UT8IFG/karpaty-rx/README.md

# Реплика радиоприемника «Карпаты»

Проект по оцифровке материалов и доработке радилюбительского КВ-приемника «Карпаты», опубликованного в журнале «Радио» (№11-12 за 1987 год).

## 📌 О проекте
Цель проекта — оцифровать печатные платы для сборки радиоприемника, упростить возможность модификации печатных плат под имеющиеся радиокомпоненты.
* **Авторы приемника:** Ю. Бахмутский (UB4LGP), В. Калаев (RB5LEN)
* **Первоисточник:** Журнал «Радио», [№11 1987 г. (стр. 31–33)](http://archive.radio.ru/web/1987/11/), [№12 1987 г. (стр. 19–21, вкл. 2-3)](http://archive.radio.ru/web/1987/12/).
* **Технологии:** Sprint-Layout 6.0.

## 📂 Структура репозитория
* `/docs/original-articles/` — оригинальные сканы страниц журнала в формате JPG.
* `/docs/datasheet/` — справочные материалы.
* `/sch/` — принципиальные электрические схемы.
* `/pcb/` — файлы печатных плат.
* `/pcb/mod/` — модифицированные файлы печатных плат.
* `/pcb/*/img/` — изображения печатных плат.
* `/pcb/macros/` — созданные в процессе работы макросы для Sprint-Layout.

## 🛠 Технические подробности
Печатные платы оптимизированы под домашнее производство с помощью ЛУТ: крупные контактные площадки, толстые дорожки, минимальный диаметр отверстий - 0,8 мм. 

**Внимание!**  Шелкография для диодов КД522Б соотвествует их внешнему виду, то есть широкая полоса обозначает **анод**. При установке диодов 1N4148 необходимо учитывать, что полоска на корпусе диода указывет на **катод**.

## ✅ Статус оцифровки печатных плат

Нажмите на изображение платы, чтобы перейти к файлу в формате `.lay6`.

### Плата №1 (ДПФ)
На плате расположены диапазонные фильтры сосредоточенной селекции.

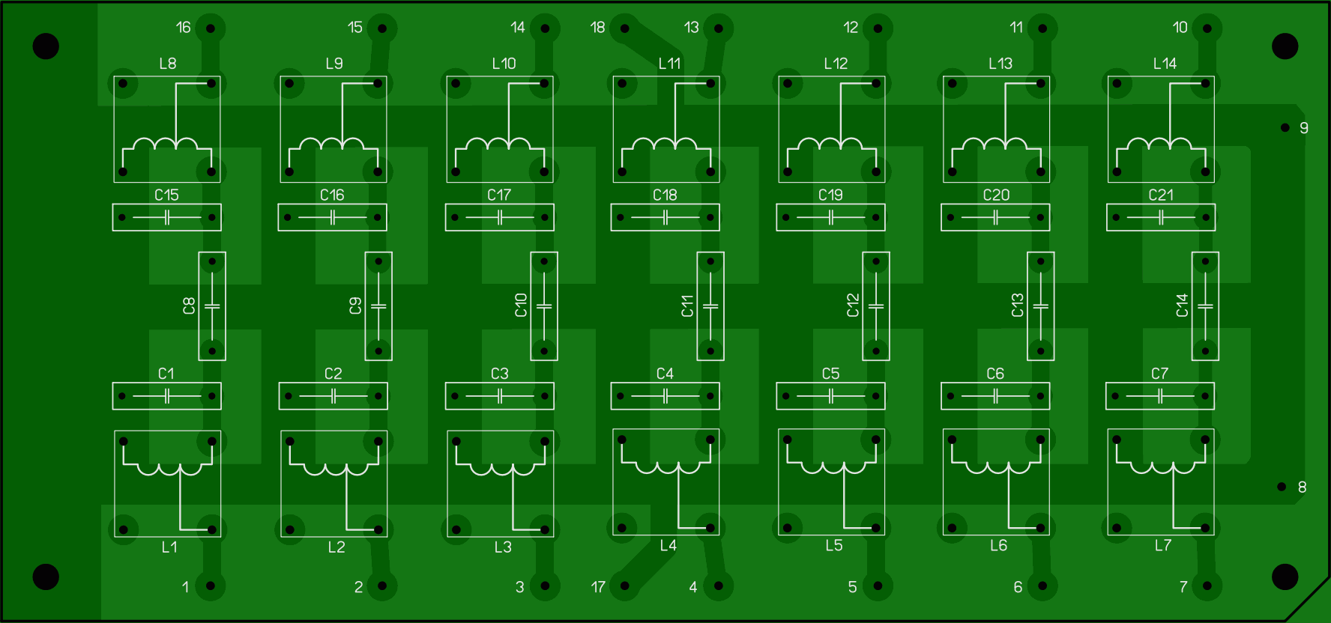
[picture p1: pcb/original/img/karpaty-rx-pcb1-bpf-orig-preview.png]
Плата №1 Фотовид


### Плата №2 (УРЧ + первый смеситель)
На плате расположен усилитель радиочастоты, согласующий каскад и первый смеситель.

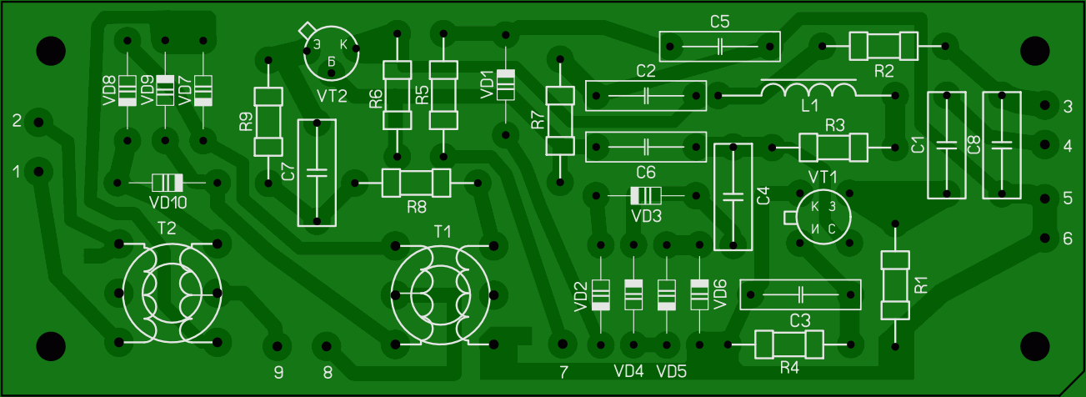
[picture p2: pcb/original/img/karpaty-rx-pcb2-rfamp-1st-mixer-orig-preview.png]
Фотовид платы УРЧ и первого смесителя приемника Карпаты


### Плата №3 (ГПД)
Плата генератора плавного диапазона (ГПД).

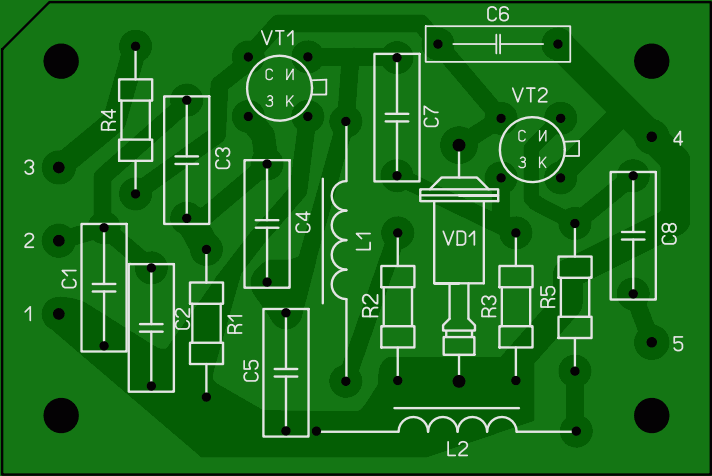
[picture p3: pcb/original/img/karpaty-rx-pcb3-vfo-orig-preview.png]
Фотовид платы ГПД приемника Карпаты


### Плата №4
Не является печатной платой. 

Содержит подстроечные и постоянные конденсаторы, задающие границы работы ГПД на диапазонах. 

Элементы монтируются на металлической пластине навесным монтажом.

### Плата №5 (Повторители + удвоитель частоты)
Плата содержит повторители и удвоитель частоты ГПД.

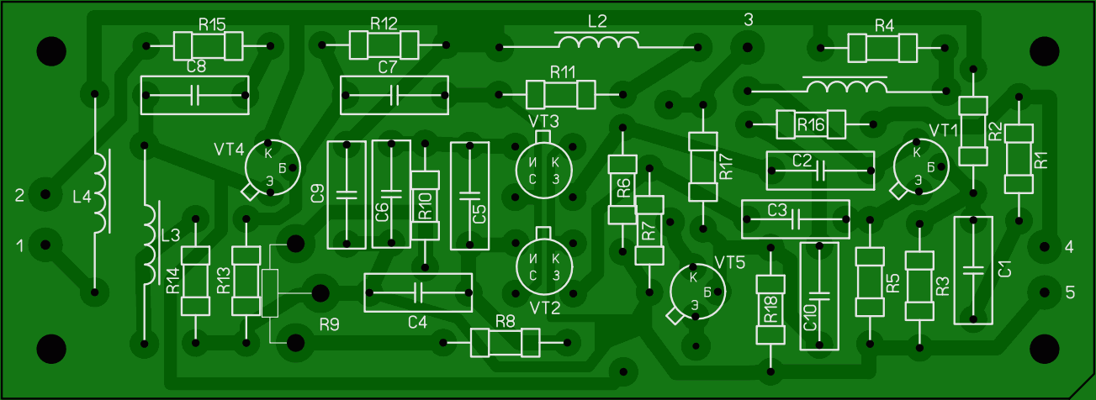
[picture p4: pcb/original/img/karpaty-rx-pcb5-buffer-freq-doubler-orig-preview.png]
Фотовид платы повторителей и удвоения частоты приемника Карпаты


### Плата №6 (Основная плата)
Центральный блок приемника, содержащий второй смеситель, тракт ПЧ, опорные генераторы, АРУ, детектор и УНЧ.

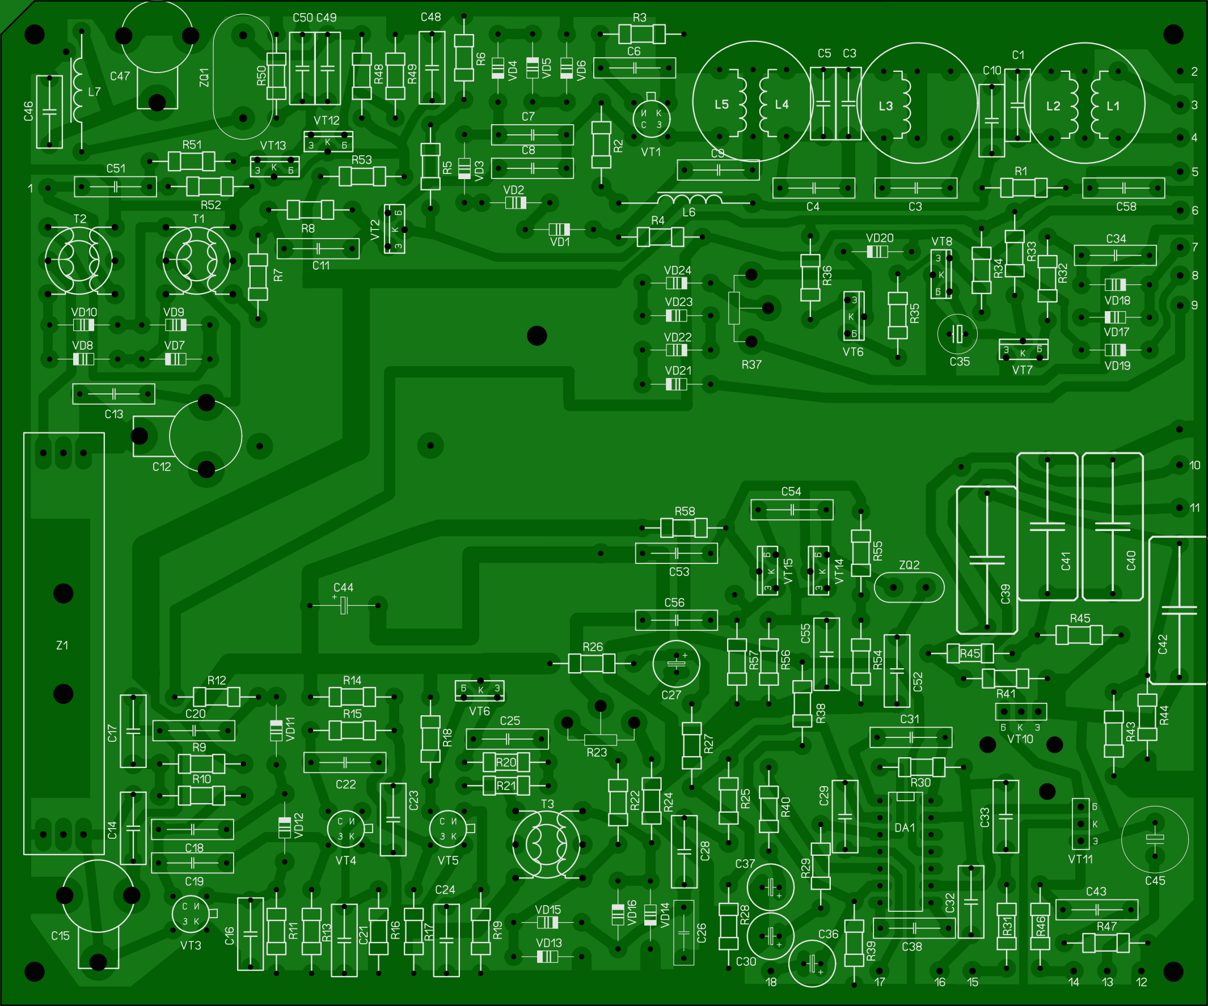
[picture p5: pcb/original/img/karpaty-rx-pcb6-mainboard-orig-preview.png]
Плата №6 Фотовид


### Плата №7 (Блок питания)
Плата источника питания. Содержит выпрямитель, фильтрующие ёмкости и стабилизатор напряжения.

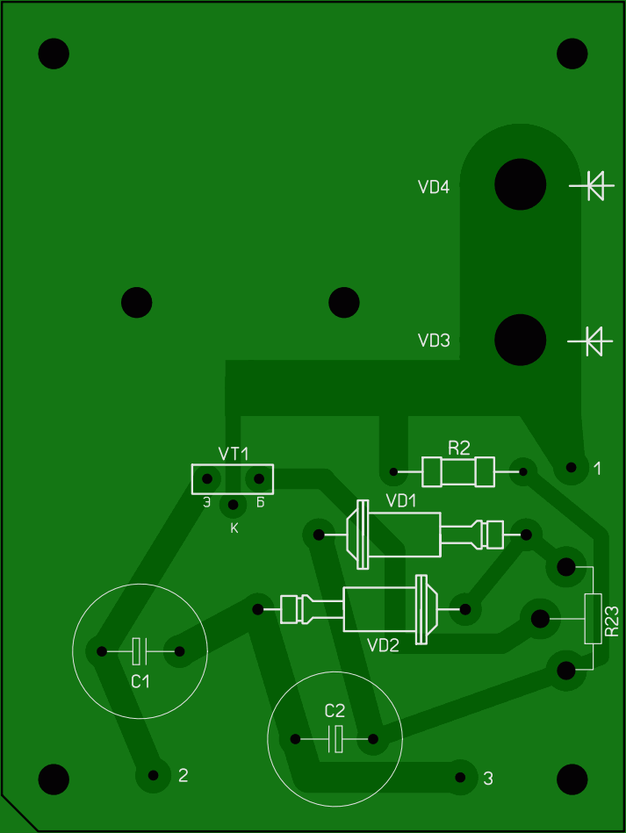
[picture p6: pcb/original/img/karpaty-rx-pcb7-power-supply-orig-preview.png]
Фотовид платы блока питания приемника Карпаты


## 🔧 Модифицированные печатные платы
Модификации оригинальных печатных плат под имеющиеся радиокомпоненты или из других соображений. 

### Плата №1 (ДПФ)

#### Модификация платы под имеющиеся каркасы контурных катушек

Фото каркасов:
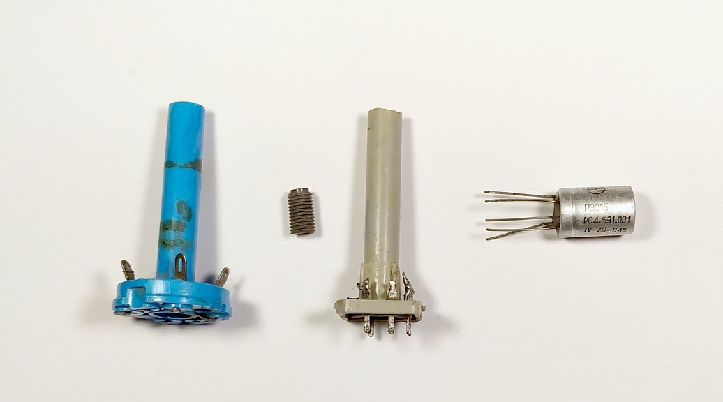
[picture p7: pcb/mod/img/karpaty-rx-pcb1-bpf-mod-components.jpg]
Фото радиокомпонентов модифицированной платы ДПФ приемника Карпаты


Плата:
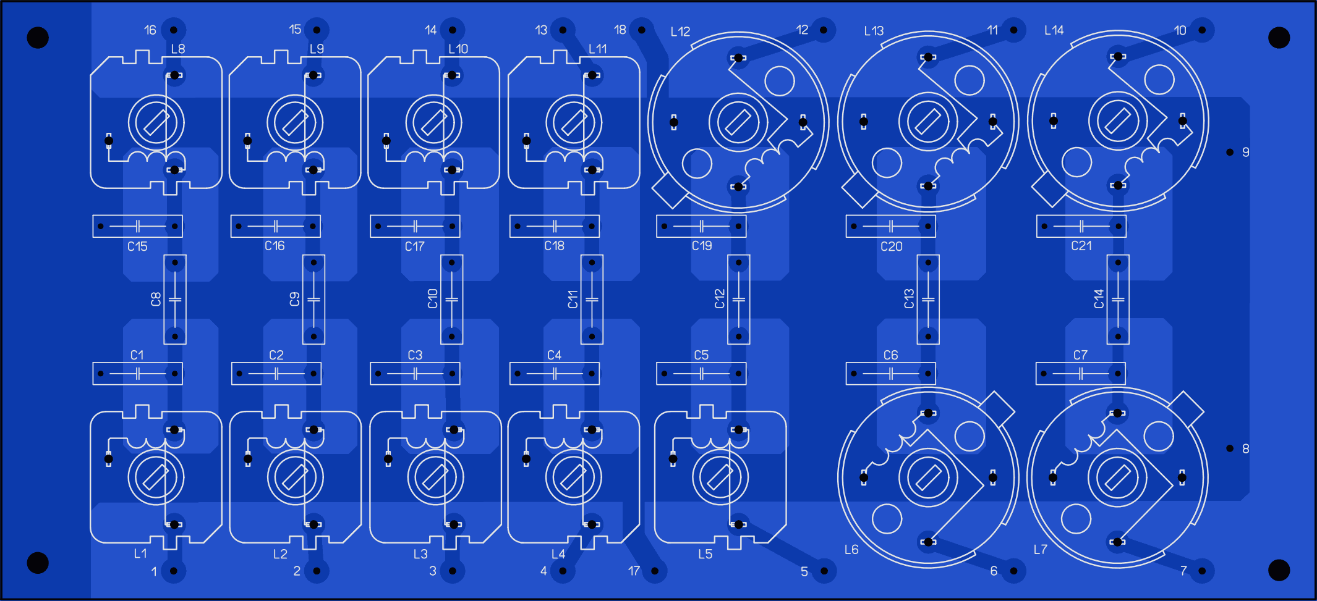
[picture p8: pcb/mod/img/karpaty-rx-pcb1-bpf-mod-preview.png]


---
#### Модификация платы под микроконтроллерное управление с релейной коммутацией

В качестве переключающего элемента использованы реле РЭС15 на напряжение 27В (паспорт PC4.591.0011П2). 

Управление реализовано на транзисторах КТ940 (с любой буквой). Каждый транзистор переключает два реле. 

***При использовании реле РЭС15 с другим паспортом может потребоваться замена транзистора на более подходящий по току.***

Схема коммутации:

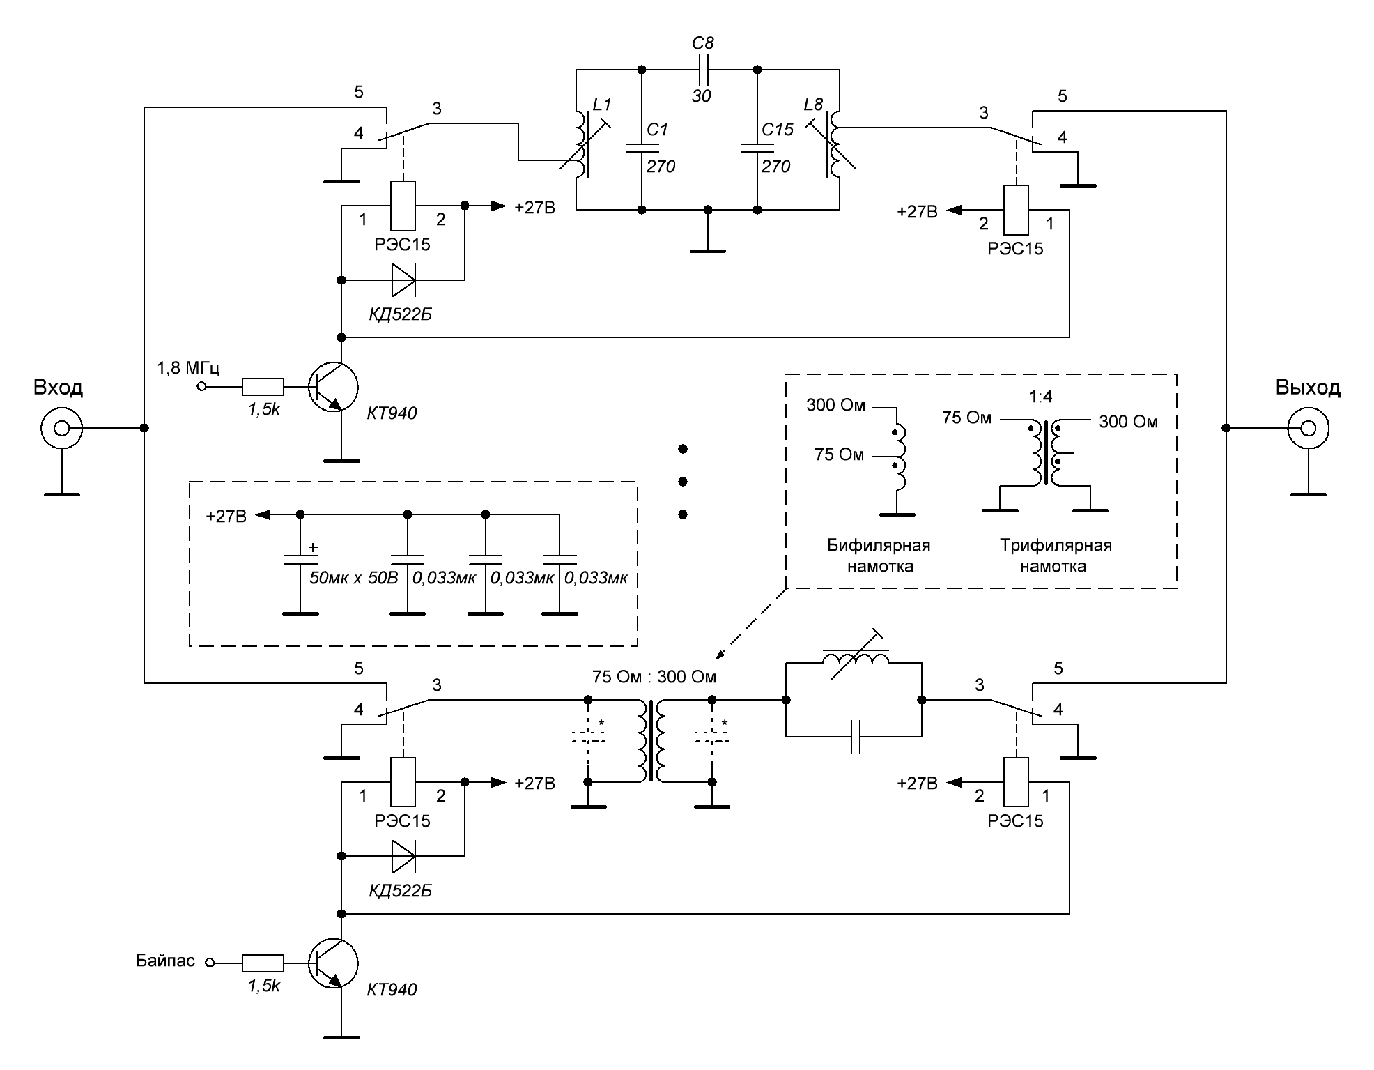
[picture p9: sch/bpf-relay-switch.png]
Схема релейной коммутации ДПФ приемника Карпаты


В схему коммутации добавлен режим обхода ("байпас") для возможности прослушивания сигналов за пределом фиксированных радиолюбительских диапазонов.

Так как приемник супергетеродинный, то такой режим сильно ухудшает избирательные свойства по зеркальному каналу. 

В режиме обхода добавлен согласующий широкополосный трансформатор сопротивлений 1:4 и режекторный фильтр на частоту первой ПЧ - 5 МГц. Эти меры должны улучшить согласование антенны с фильтром и избавить от возможных мешающих сигналов на первой ПЧ, которые могут прослушиваться при настройке приемника на любую частоту.

Трансформатор выполнен на ферритовом кольце, а катушка режекторного фильтра - на том же каркасе, что и катушки полосовых фильтров.

Конденсаторы на входе и выходе трансформатора устанавливаются при завале АЧХ, а их емкость подбирается в диапазоне 5-47 пФ.

***Данные о трансформаторе и режекторном фильтре будут уточняться в процессе сборки и наладки приемника.***

Размер платы - 205 мм Х 140 мм.

Плата:

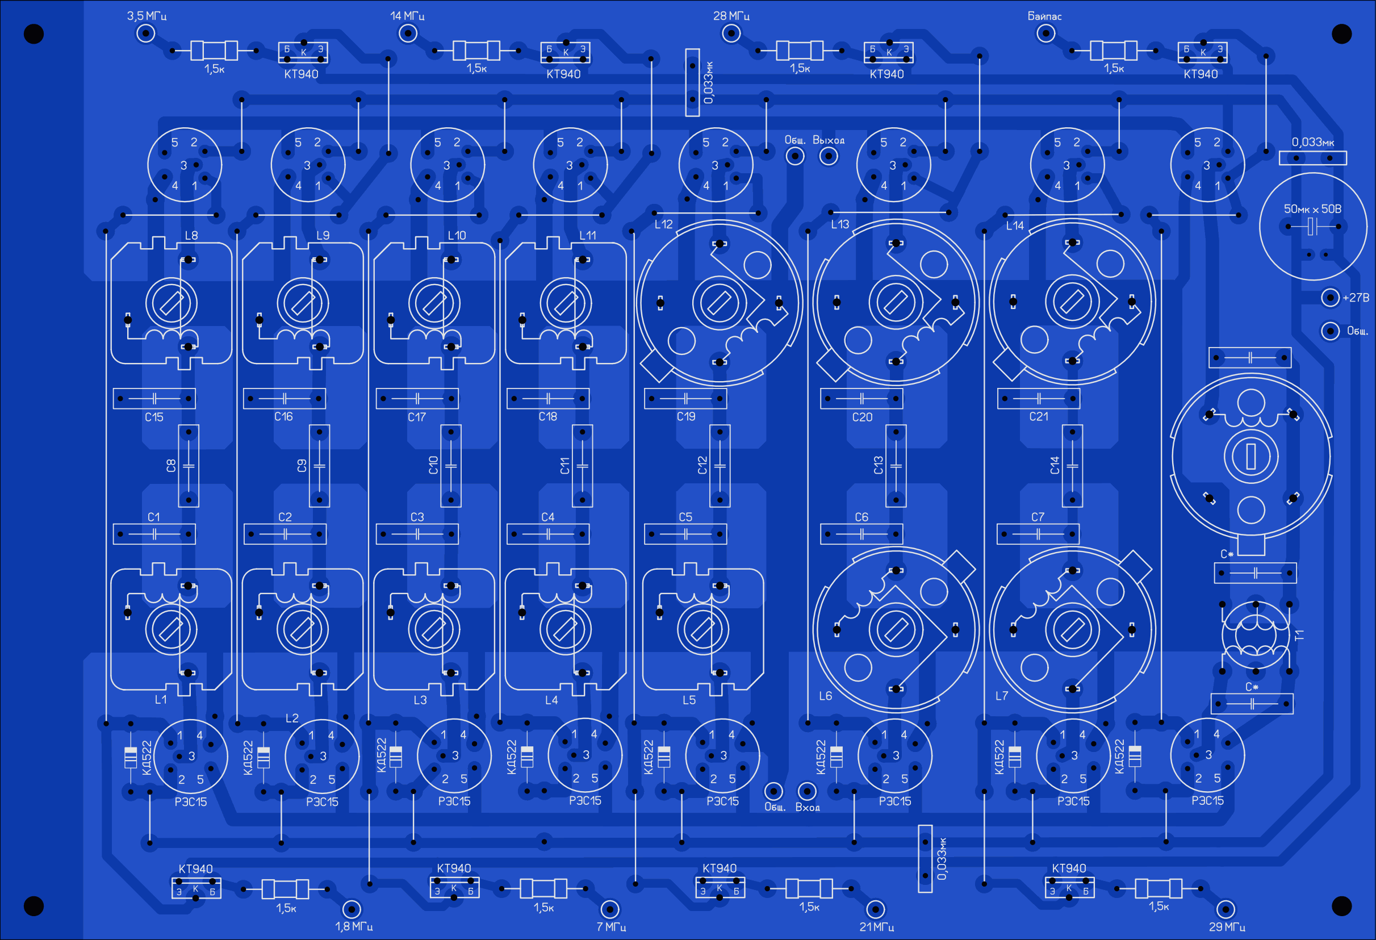
[picture p10: pcb/mod/img/karpaty-rx-pcb1-bpf-relay-mod-preview.png]
Фотовид модифицированной платы ДПФ приемника Карпаты с релейной коммутацией


Вход и выход ВЧ-сигнала подключаются к контактным площадкам "Вход", "Общ." и "Выход", "Общ." соответственно.

Для заземления корпусов реле предусмотрены контактные площадки в непосредственной близости с корпусом.

Питание для реле подается на контакты "+27В" и "Общ.". Общий провод питания изолирован от сигнальной "земли" платы, чтобы не создавать земляных петель и разделить сигнальную и управляющую части. 

Фильтрация питания реле состоит из электролитического конденсатора 20-50 мкФ х 50 В (К50-6) и трех керамических конденсаторов на 33-100 нФ (например К10-7). Предусмотрено посадочное место под установку современного электролитического конденсатора значительно меньшего размера.

### Плата №6 (Основная плата)
Модификация платы под имеющиеся радиокомпоненты. 

Список основных изменений:
* заменены посадочные места и шелкогарфия контуров полосового фильтра L1-L5;
* C35, C37: добавлены посадочные места под ниобиевые конденсаторы К53-4;
* C1, C3, C5: добавлены посадочные места под КСО-1;
* С2, С4: добавлены посадочные места под КД-1-3;
* C13, C14: добавлены посадочные места под КТ-2;
* C31, C38 уменьшен размер под дисковый керамический;
* VT10, VT11: добавлены радиаторы и крепеж;
* Удалены отверстия крепления радиатора;
* С45 заменен на К50-6 200 мкФ х 25В, старое посадочное место сохранено.

Фото компонентов:
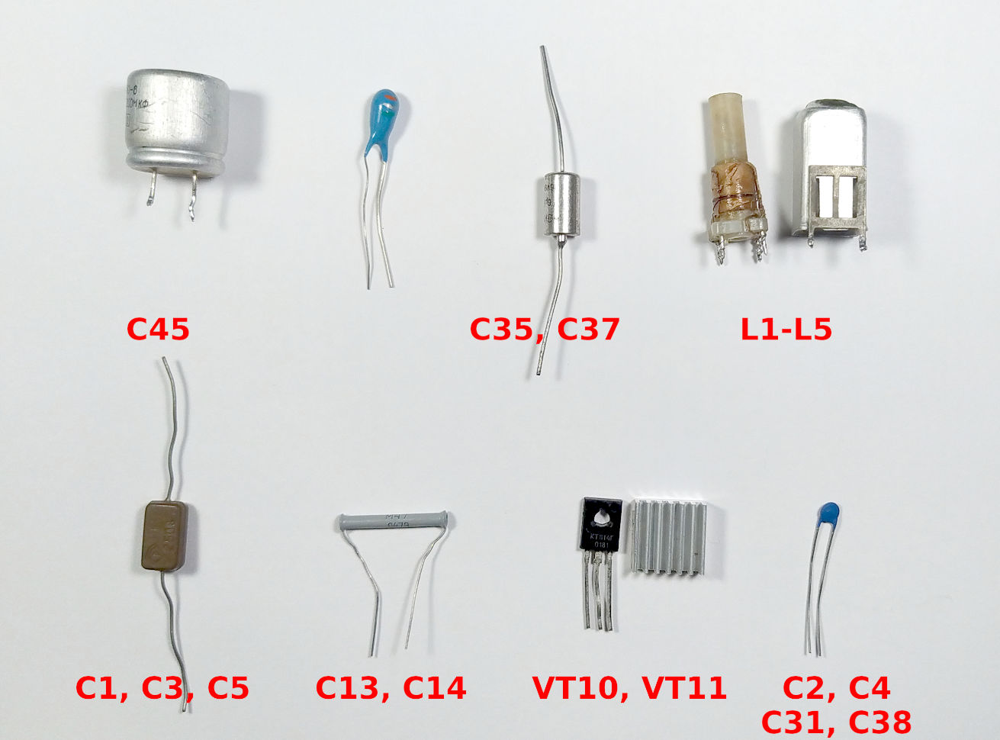
[picture p11: pcb/mod/img/karpaty-rx-pcb6-mainboard-mod-components.jpg]
Фото радиокомпонентов модифицированной основной платы приемника Карпаты


Плата:
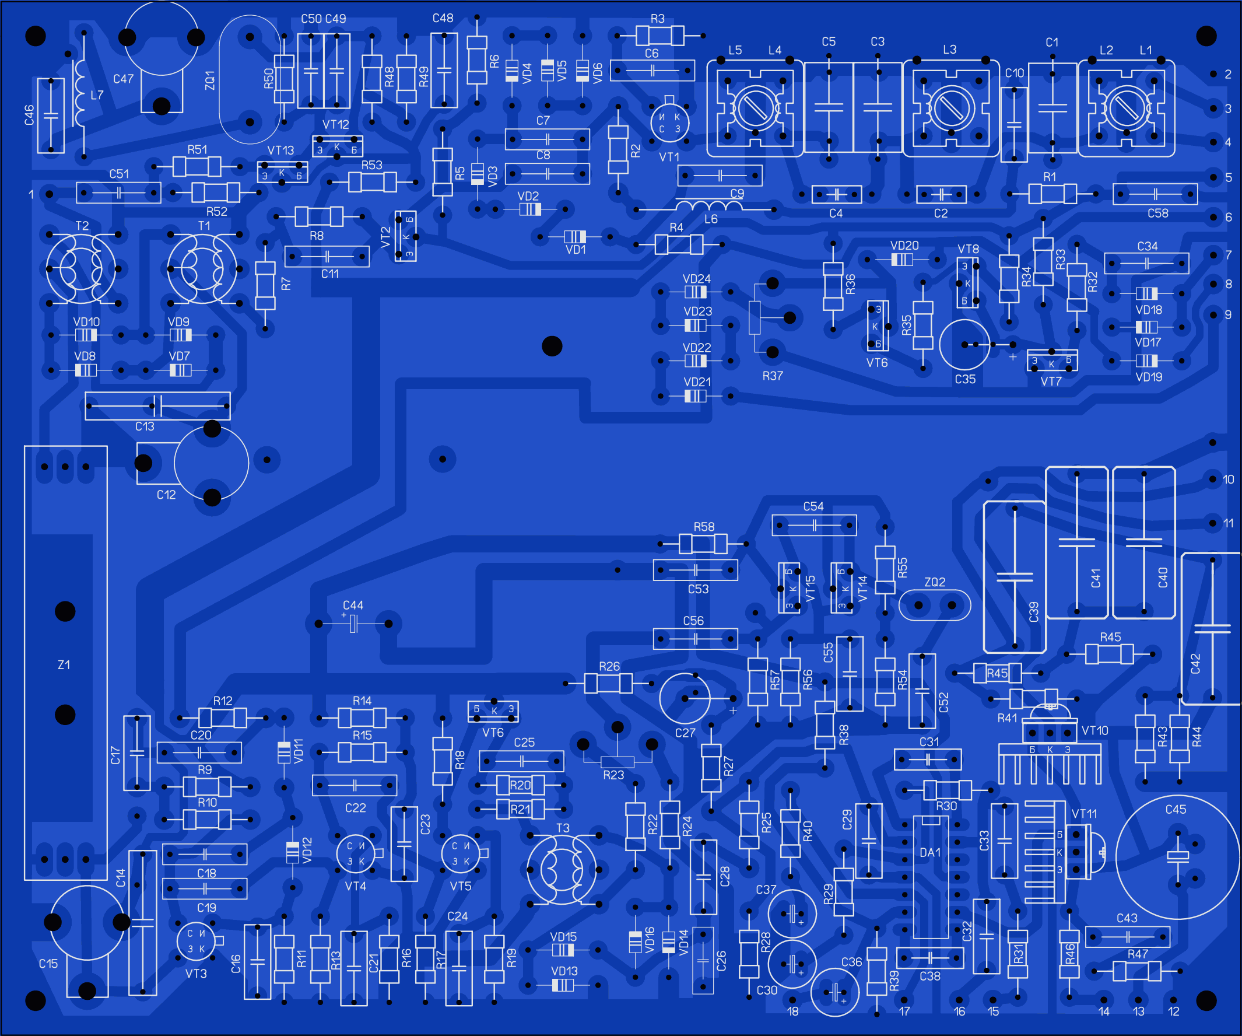
[picture p12: pcb/mod/img/karpaty-rx-pcb6-mainboard-mod-preview.png]


<a href="pcb/mod/img/karpaty-rx-pcb6-mainboard-mod-compare-preview.gif">Анимированное изображение</a> внесённых изменений относительно оригинальной платы.

---
*Проект находится в стадии наполнения.*
