UT8IFG/karpaty-rx/docs/original-articles/b.1987-11.035.jpg

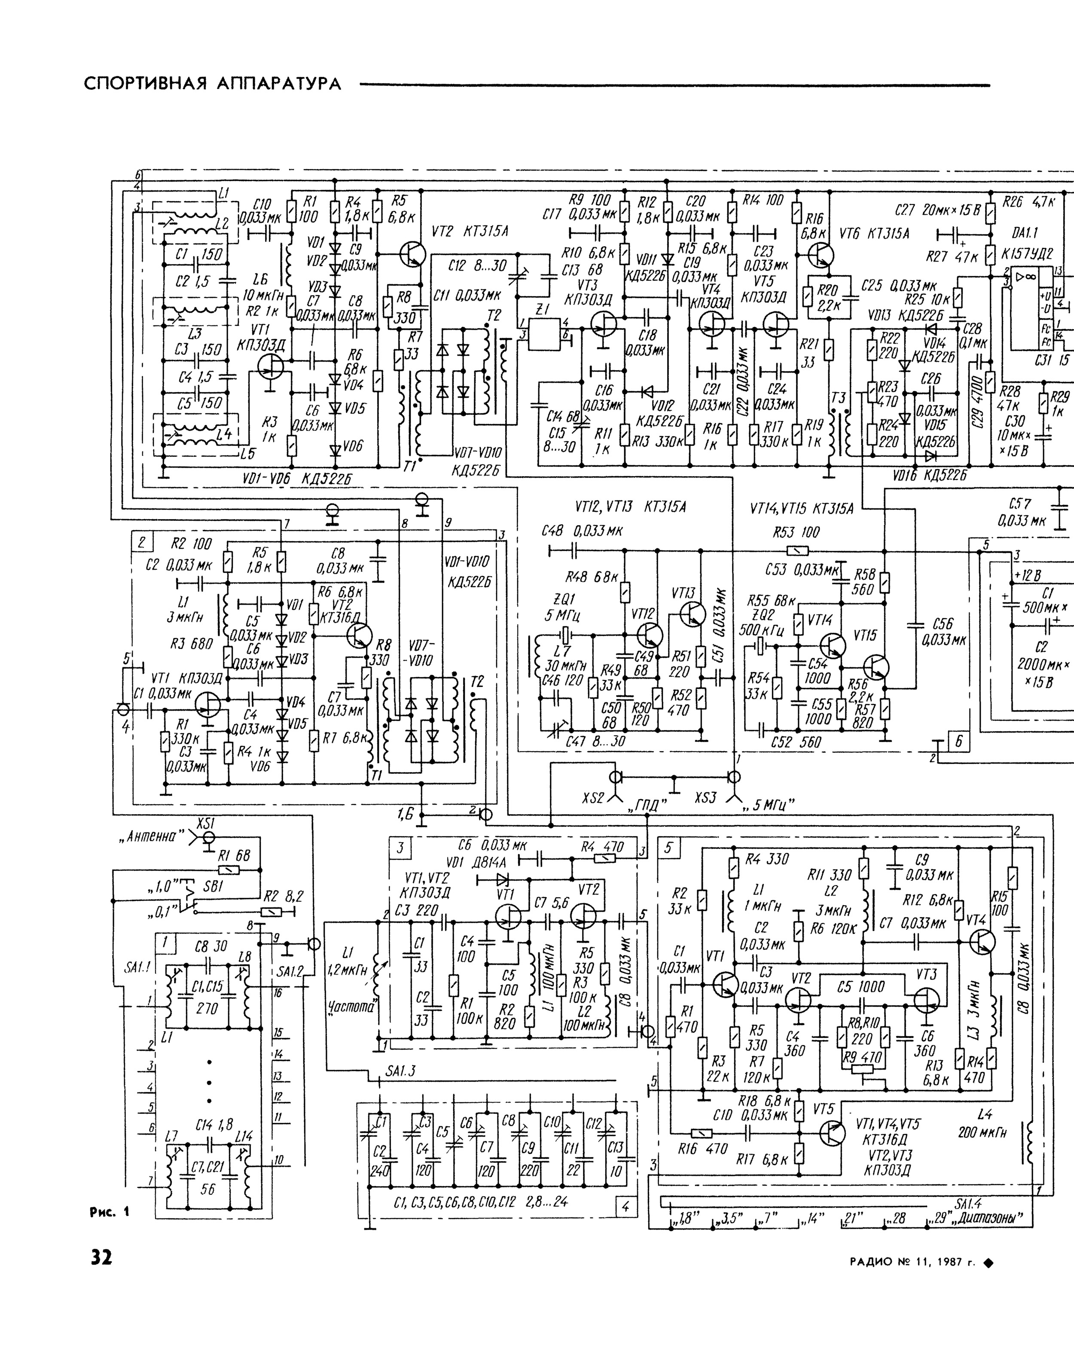
docs/original-articles/b.1987-11.035.jpg
