UT8IFG/karpaty-rx/docs/original-articles/b.1987-12.020.jpg

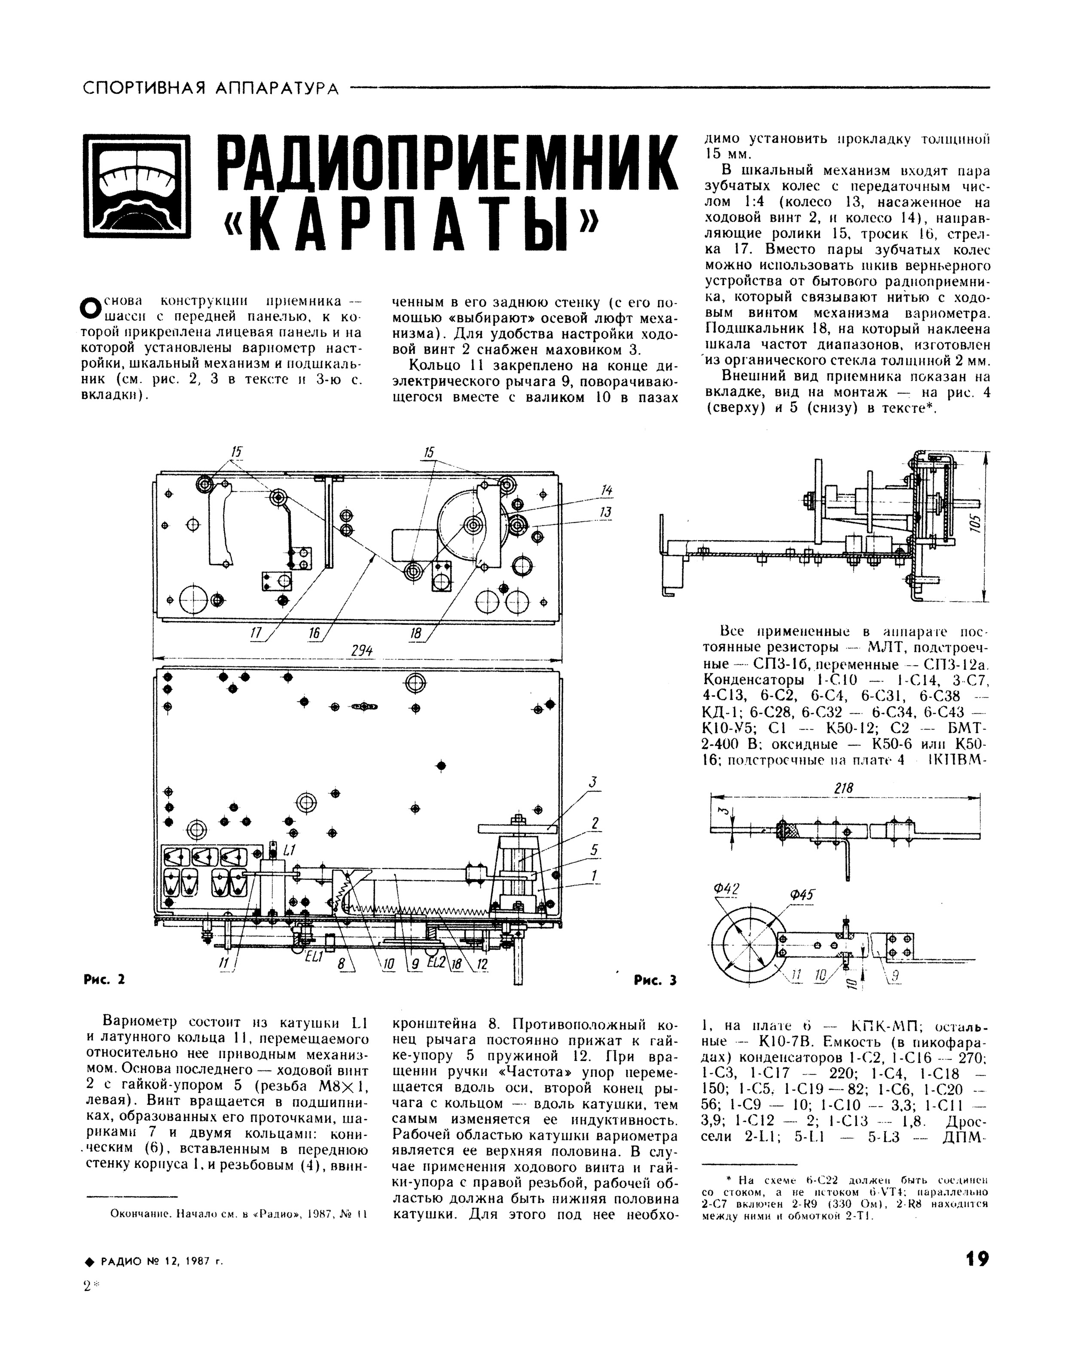
docs/original-articles/b.1987-12.020.jpg
