UT8IFG/karpaty-rx/docs/original-articles/b.1987-12.022.jpg

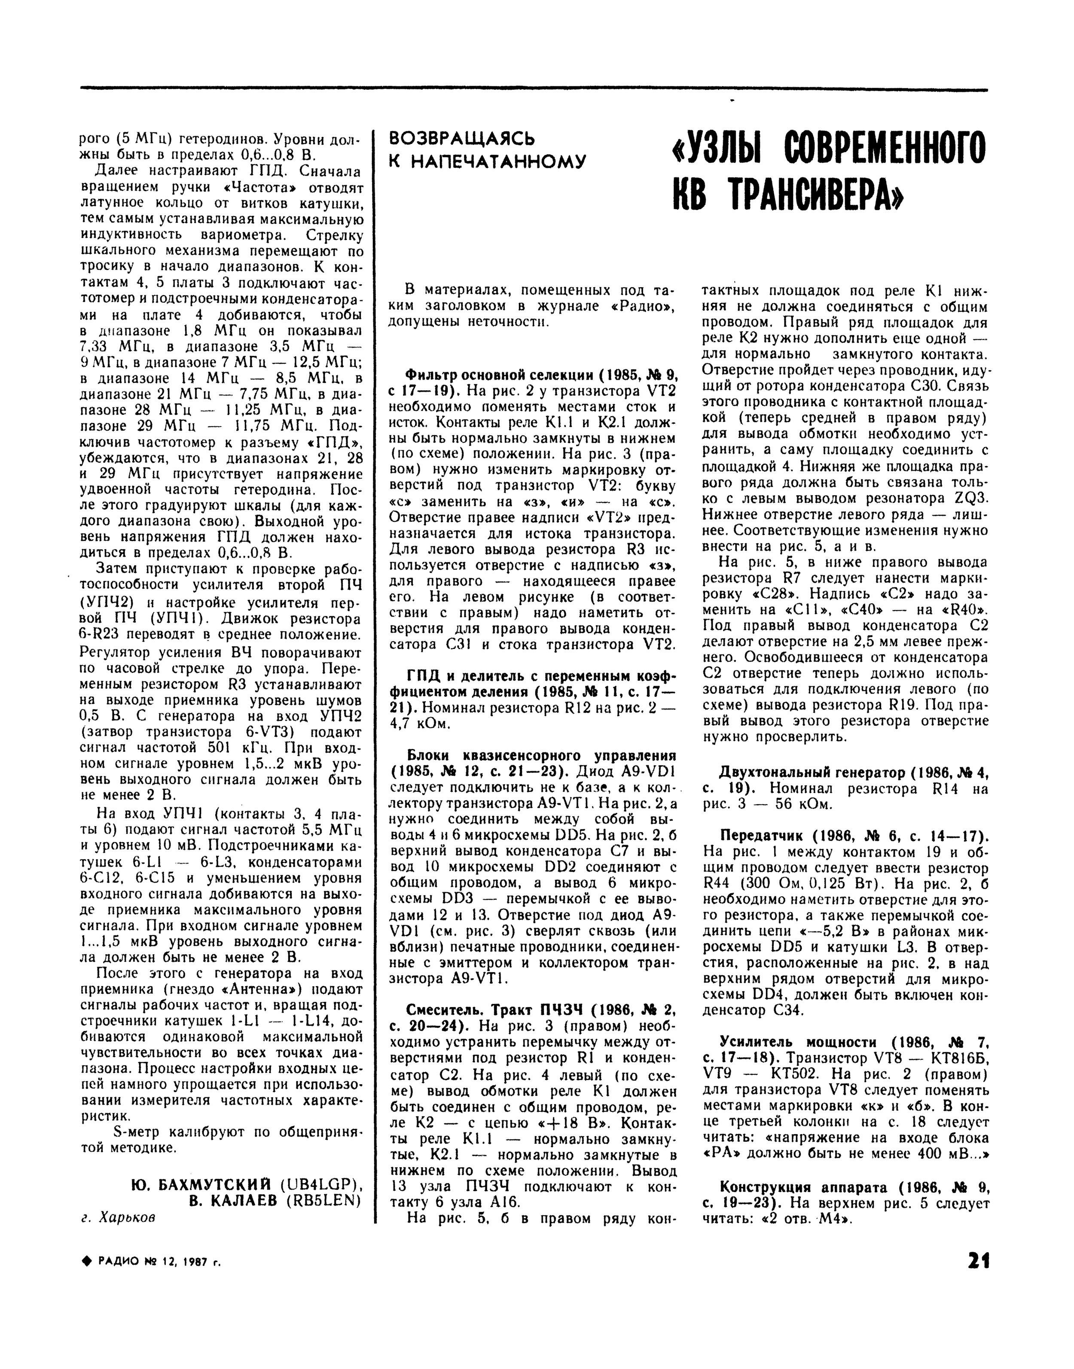
docs/original-articles/b.1987-12.022.jpg
