UT8IFG/karpaty-rx/docs/original-articles/b.1987-12.035.jpg

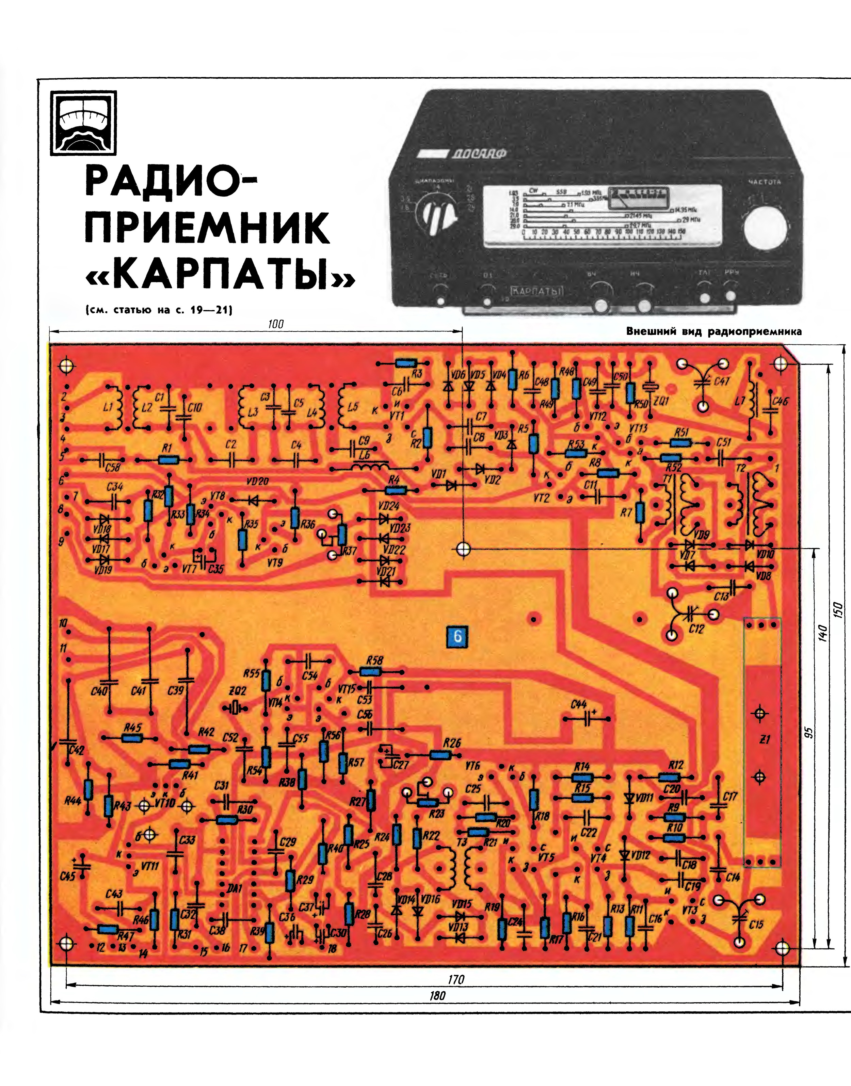
docs/original-articles/b.1987-12.035.jpg
