UT8IFG/karpaty-rx/docs/original-articles/b.1987-12.036.jpg

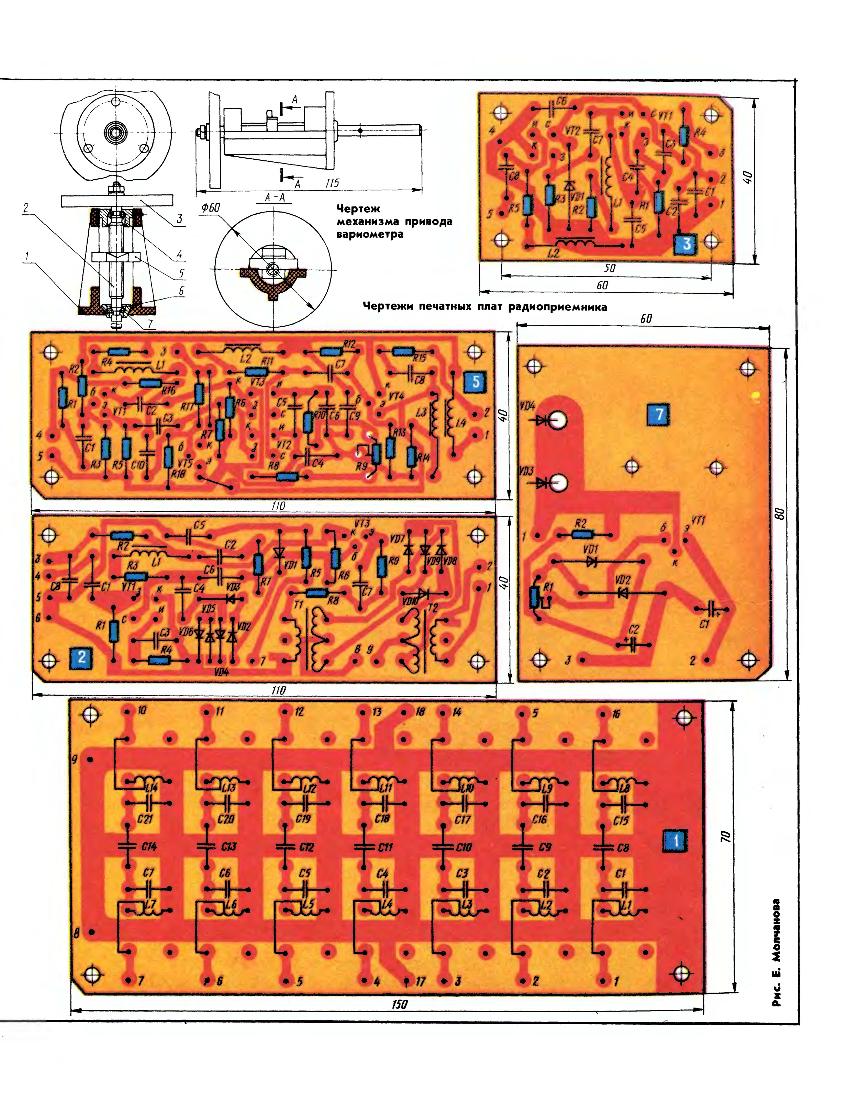
docs/original-articles/b.1987-12.036.jpg
