UT8IFG/karpaty-rx/pcb/macros/coil-if2.png

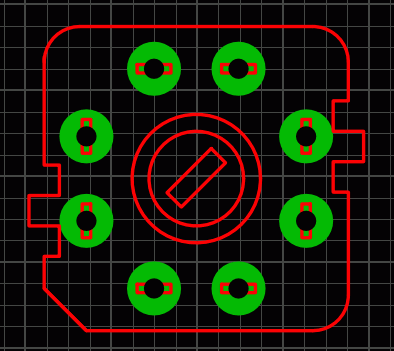
pcb/macros/coil-if2.png
