UT8IFG/karpaty-rx/pcb/macros/coil-if.png

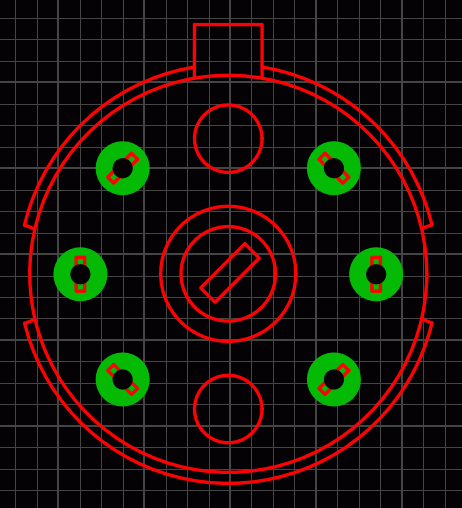
pcb/macros/coil-if.png
