UT8IFG/karpaty-rx/sch/karpaty-rx-schematic.png

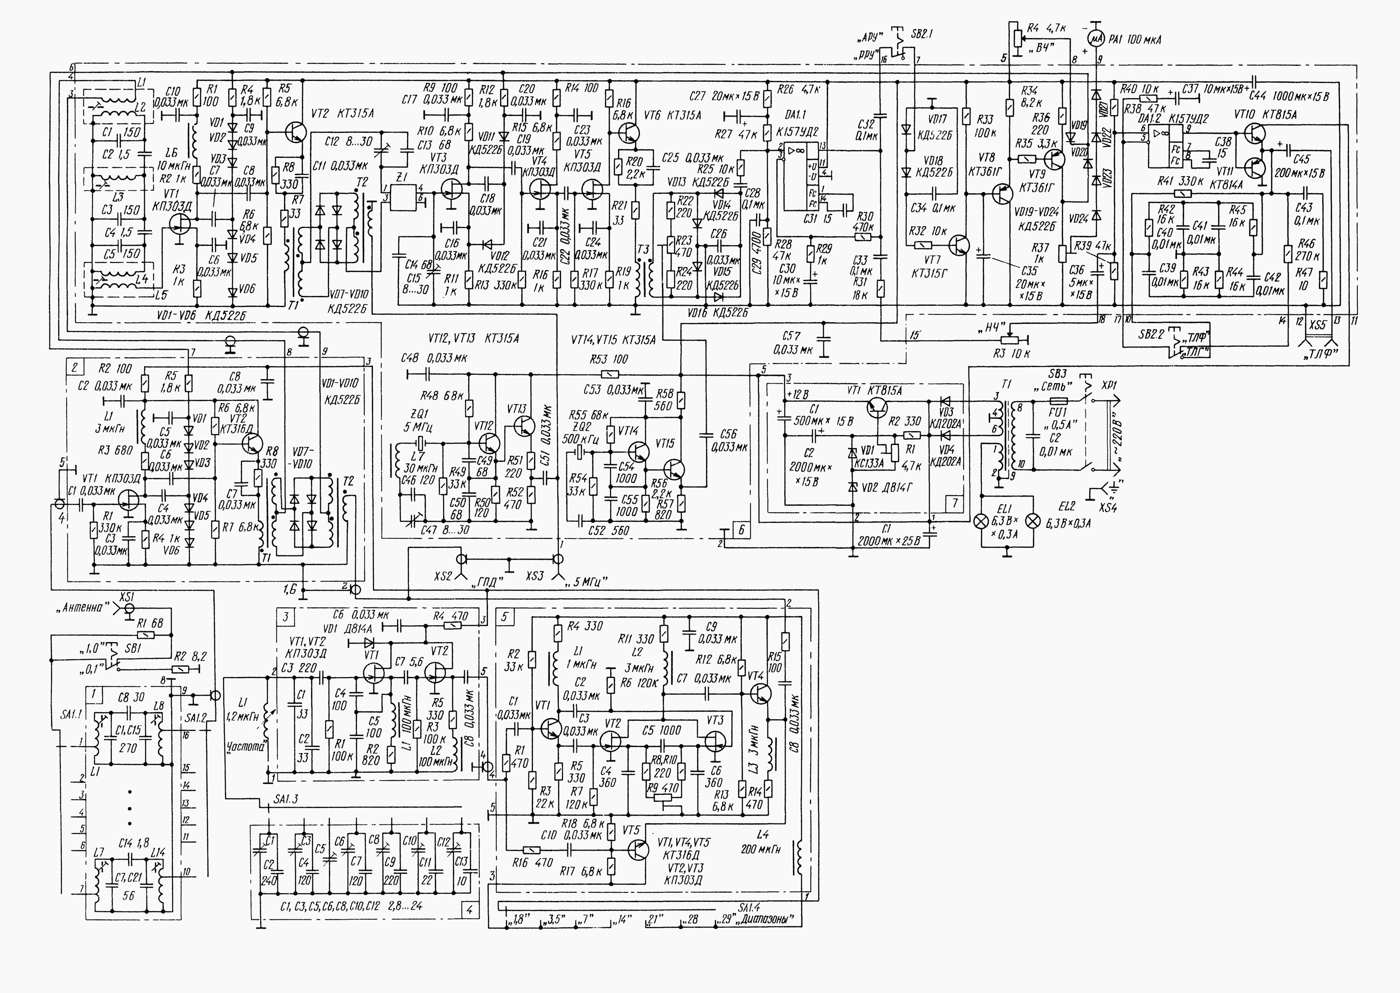
sch/karpaty-rx-schematic.png
