UT8IFG/karpaty-rx/(list of files, drawings)

Other design files:
pcb/mod/karpaty-rx-pcb1-bpf-mod.lay6
pcb/mod/karpaty-rx-pcb1-bpf-relay-mod.lay6
pcb/mod/karpaty-rx-pcb6-mainboard-mod.lay6
pcb/original/karpaty-rx-pcb1-bpf-orig.lay6
pcb/original/karpaty-rx-pcb2-rfamp-1st-mixer-orig.lay6
pcb/original/karpaty-rx-pcb3-vfo-orig.lay6
pcb/original/karpaty-rx-pcb5-buffer-freq-doubler-orig.lay6
pcb/original/karpaty-rx-pcb6-mainboard-orig.lay6
pcb/original/karpaty-rx-pcb7-power-supply-orig.lay6
sch/bpf-relay-switch.spl7
