UT8IFG/karpaty-rx/(commit log)

2026-01-18 chore: добавлен .gitignore
2026-01-18 docs: добавлены оригинальные сканы статей из журнала Радио
2026-01-18 hw: добавлена принципиальная схема приемника Карпаты
2026-01-18 docs: добавлен README
2026-01-19 hw: добавлена разводка основной платы приемника (6)
    [karpaty-rx-pcb6-mainboard-orig.lay6]
2026-01-19 docs: добавлен фотовид основной платы приемника (6)
2026-01-19 docs: обновлен README
2026-01-19 docs: исправлена опечатка в описании
2026-01-19 hw: добавлены метаданные с описанием в файл платы #6
    [karpaty-rx-pcb6-mainboard-orig.lay6]
2026-01-19 hw: добавлена плата №2 (УРЧ и первый смеситель)
    [karpaty-rx-pcb2-rfamp-1st-mixer-orig.lay6]
2026-01-19 docs: добавлен фотовид платы №2 (УРЧ и первый смеситель)
2026-01-19 fix: добавлены пропущенные обозначения контактов и обновлен фотовид платы №2
    [karpaty-rx-pcb2-rfamp-1st-mixer-orig.lay6]
2026-01-22 hw: добавлена плата №1 (ДПФ)
    [karpaty-rx-pcb1-bpf-orig.lay6]
2026-01-22 docs: добавлен фотовид платы №1 (ДПФ)
2026-02-07 hw: добавлена плата №5 (Повторитель и удвоитель частоты)
    [karpaty-rx-pcb5-buffer-freq-doubler-orig.lay6]
2026-02-07 docs: добавлен фотовид платы №5 (Повторитель и удвоитель частоты)
2026-02-08 hw: добавлена плата №3 (ГПД)
    [karpaty-rx-pcb3-vfo-orig.lay6]
2026-02-08 docs: добавлен фотовид платы №3 (ГПД)
2026-02-08 docs: исправлен README
2026-02-11 hw: добавлена плата №7 (БП)
    [karpaty-rx-pcb7-power-supply-orig.lay6]
2026-02-11 fix(pcb6): исправления в разводке
    - Внесены изменения для успешного прохождения DRC теста с обновленными требованиями (зазор не меньше 0,4 мм).
    - Контакты для вшнених соединений с платой преобразованы в компоненты, а так же увеличен диаметр отверстия до 1 мм.
    [karpaty-rx-pcb6-mainboard-orig.lay6]
2026-03-10 hw:(pcb6-mod) добавлена модификация основной платы приёмника * заменены посадочные места и шелкогарфия контуров полосового фильтра L1-L5 * увеличено отверстие межплатного соединения [1]
    [karpaty-rx-pcb6-mainboard-mod.lay6]
2026-03-21 hw:(pcb6-mod) Внесены дополнительные изменения под имеющиеся компоненты * C35, C37: добавлены посадочные места под ниобиевые конденсаторы К53-4 * C1, C3, C5: добавлены посадочные места под КСО-1 * С2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
    [karpaty-rx-pcb6-mainboard-mod.lay6]
2026-04-09 docs(pcb6-mod): добавлены изображения изменений * pcb: анимированное изображение изменений на плате * фото новых компонентов
2026-04-20 hw:(pcb1-mod) Добавлена модификация платы ДПФ
    * Контактные площадки внешних соединений превращены в компоненты с обозначением (вместо площадки и отдельной надписи на шелкографии)
    * Заменены посадочные места катушек L1-L5, L8-L11 под каркасы с "квадратным" основанием
    * Заменены посадочные места катушек L6-L7, L12-L14 под каркасы с "круглым" основанием
    * Размер платы увеличен до 180 мм Х 82 мм
    * Расстоян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
    [karpaty-rx-pcb1-bpf-mod.lay6]
2026-05-12 docs(pcb1-mod): добавлено фото используемых компонентов
2026-08-08 hw:(pcb1-relay-mod) Добавлена модификация платы ДПФ с переключающими реле
    * используются реле РЭС15 на 27В
    * переключающие тарнзисторы КТ940 или другие подходящие по току и напряжению (один транзистор коммутирует обмотки двух реле)
    * добавлен режим обхода фильтров (байпас)
    * размер платы увеличен до 205 мм Х 140 мм
    [karpaty-rx-pcb1-bpf-relay-mod.lay6]
2026-09-22 hw:(pcb1-relay-mod) В режиме обхода добавлен трансформатор сопротивления и режекторный фильтр на 5МГц * добавлен трансформатор сопротивления на кольце (посадочные места упрощают монтаж трансформатора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
    [karpaty-rx-pcb1-bpf-relay-mod.lay6]
2026-09-22 hw:(pcb1-relay-mod) Добавлена схема релейной коммутации диапазонных фильтров
    [bpf-relay-switch.spl7]
2026-09-28 hw:(pcb1-relay-mod) Добавлены конденсаторы по питанию реле * по питанию реле установлены 50мкФ х 50В (К50-6) и три керамических "красных флажка" (К10-7В) на 33 нФ
    [karpaty-rx-pcb1-bpf-relay-mod.lay6]
2026-09-28 hw:(pcb1-relay-mod) Обновлена схема
    [bpf-relay-switch.spl7]
2026-09-29 docs:(datasheet) Добавлены даташиты * реле РЭС15; * транзистор КТ940; * фильтр ФЭМ2-045.
2026-09-29 docs:(pcb1-relay-mod) Мелкие исправления в обозначениях на схеме
    [bpf-relay-switch.spl7]
2026-09-29 hw:(macros) Добавлены макросы катушек ДПФ
2026-09-29 hw:(pcb1-relay-mod) Мелкие изменения * добавлено посадочное место под современный электролитический конденсатор; * уменьшена толщина сигнальной дорожки от входа/выхода до реле с 2,5 до 2 мм; * правки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
    [karpaty-rx-pcb1-bpf-relay-mod.lay6]
2026-09-29 docs(README.md): Обновление описания проекта
